tanaes/slide_led_pcb/Slide LED connector v0.2.kicad_sch

## KiCad design Slide LED connector v0.2.kicad_sch (2025-04-06)

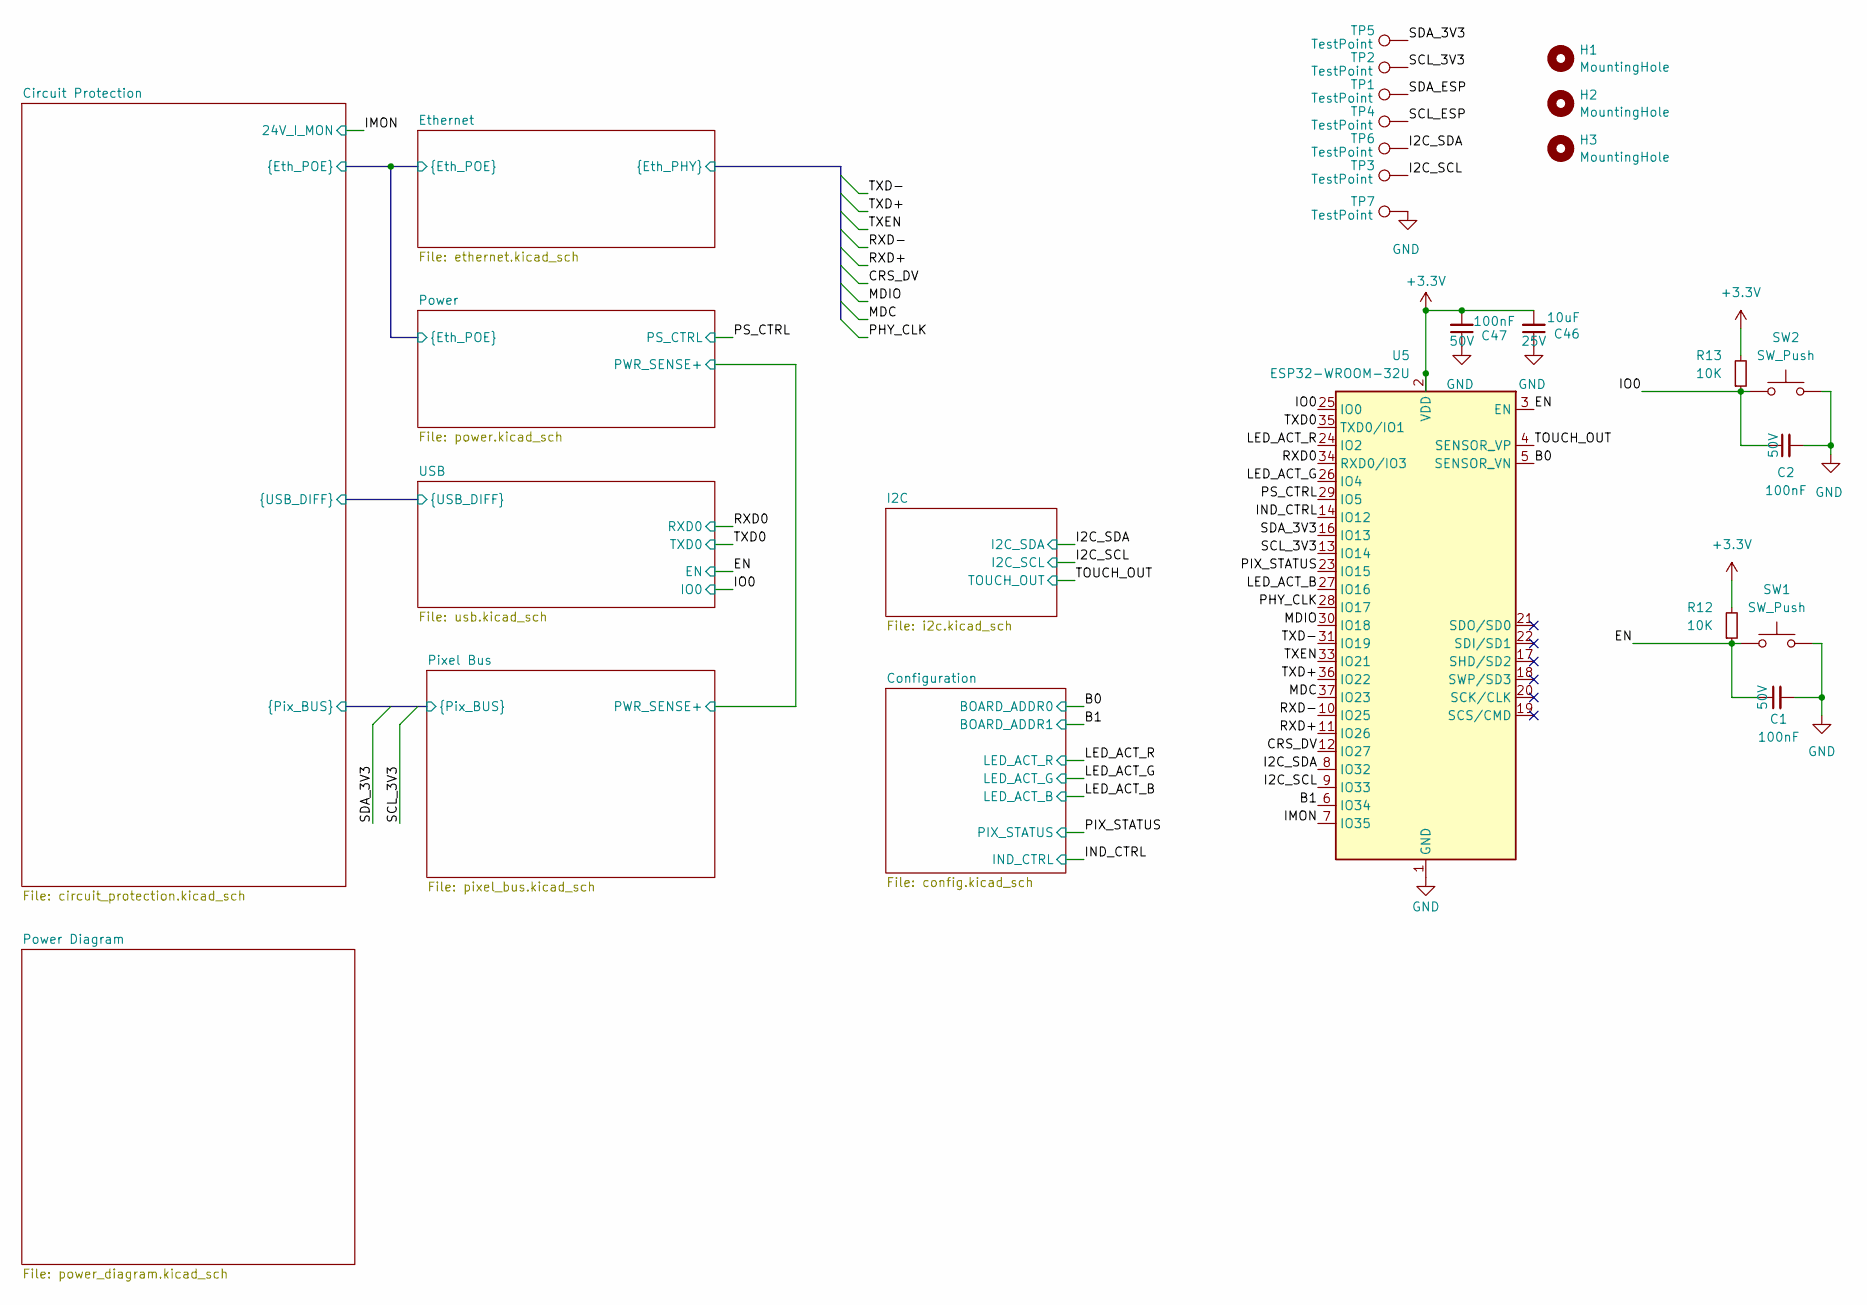
[picture p1: schematic Slide LED connector v0.2.kicad_sch]

Parts:
C1, C2, C47: 100nF; C_0603_1608Metric; Rating 50V; LCSC C14663
C46: 10uF; C_0603_1608Metric; Rating 25V; LCSC C96446
H1, H2, H3: MountingHole; MountingHole_3.2mm_M3_DIN965
R12, R13: 10K; R_0603_1608Metric; LCSC C25804
SW1, SW2: SW_Push; SW_Push_1P1T_XKB_TS-1187A; LCSC C318884
TP1, TP2, TP3, TP4, TP5, TP6, TP7: TestPoint; TestPoint_Pad_D2.0mm
U5: ESP32-WROOM-32U; LCSC C328062

Connections:
+3.3V: C46.2, C47.2, R12.2, R13.2, U5.2 (VDD)
B0: U5.5 (SENSOR_VN)
B1: U5.6 (IO34)
CRS_DV: U5.12 (IO27)
EN: C1.1, R12.1, SW1.1, U5.3 (EN)
GND: C1.2, C2.2, C46.1, C47.1, SW1.2, SW2.2, TP7.1, U5.1 (GND), U5.15 (GND), U5.38 (GND), U5.39 (GND)
I2C_SCL: TP3.1, U5.9 (IO33)
I2C_SDA: TP6.1, U5.8 (IO32)
IMON: U5.7 (IO35)
IND_CTRL: U5.14 (IO12)
IO0: C2.1, R13.1, SW2.1, U5.25 (IO0)
LED_ACT_B: U5.27 (IO16)
LED_ACT_G: U5.26 (IO4)
LED_ACT_R: U5.24 (IO2)
MDC: U5.37 (IO23)
MDIO: U5.30 (IO18)
PHY_CLK: U5.28 (IO17)
PIX_STATUS: U5.23 (IO15)
PS_CTRL: U5.29 (IO5)
RXD0: U5.34 (RXD0/IO3)
RXD+: U5.11 (IO26)
RXD-: U5.10 (IO25)
SCL_3V3: TP2.1, U5.13 (IO14)
SCL_ESP: TP4.1
SDA_3V3: TP5.1, U5.16 (IO13)
SDA_ESP: TP1.1
TOUCH_OUT: U5.4 (SENSOR_VP)
TXD0: U5.35 (TXD0/IO1)
TXD+: U5.36 (IO22)
TXD-: U5.31 (IO19)
TXEN: U5.33 (IO21)
