tanaes/slide_led_pcb/circuit_protection.kicad_sch

## KiCad design circuit_protection.kicad_sch (2025-04-06)

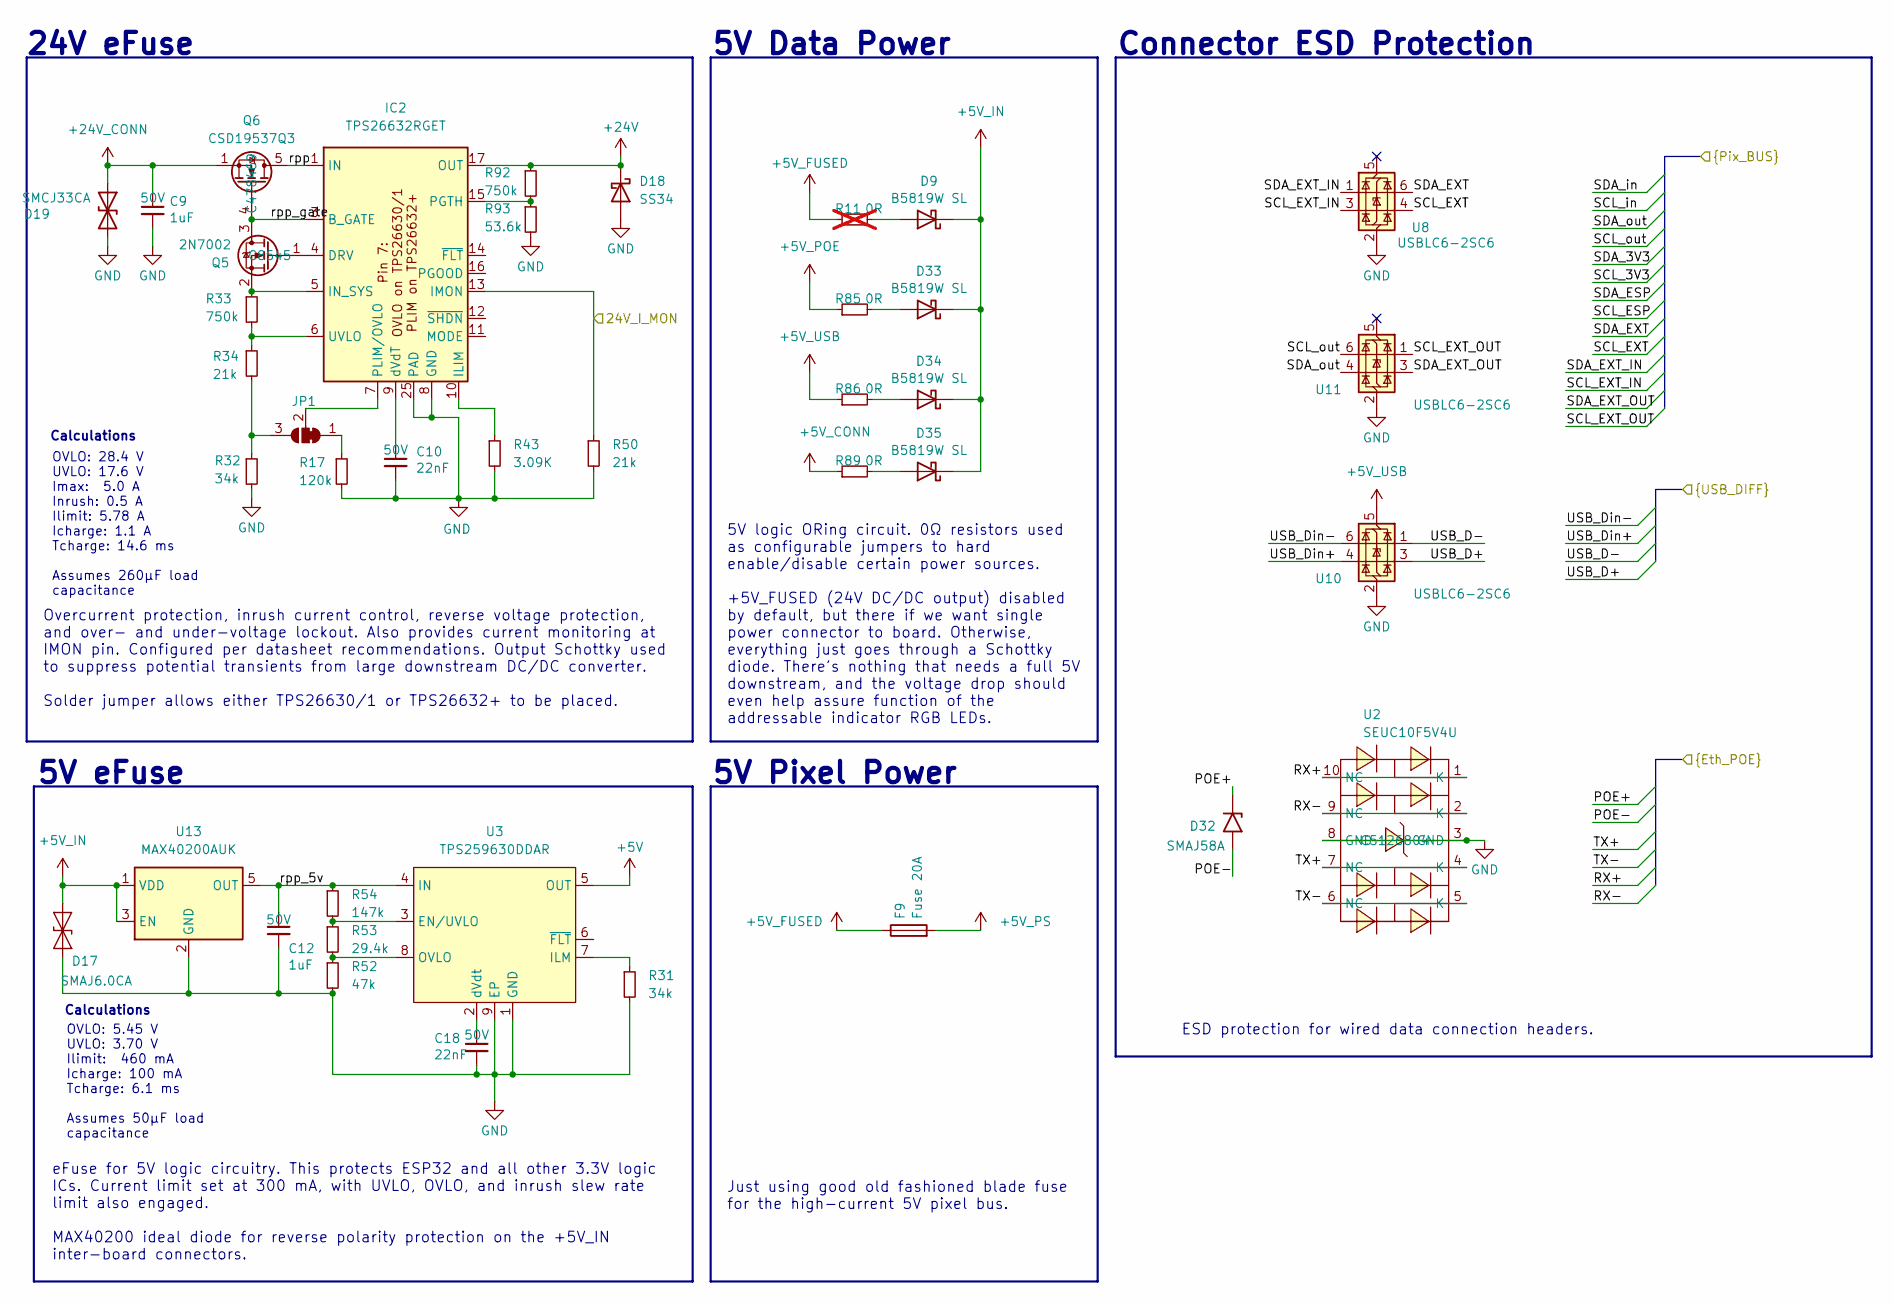
[picture p2: schematic circuit_protection.kicad_sch]

Parts:
C9, C12: 1uF; C_0603_1608Metric; Rating 50V; LCSC C15849
C10, C18: 22nF; C_0603_1608Metric; Rating 50V; LCSC C21122
D9, D33, D34, D35: B5819W SL; D_SOD-123; LCSC C8598
D17: SMAJ6.0CA; D_SMA; LCSC C80275
D18: SS34; D_SMA; LCSC C8678
D19: SMCJ33CA; D_SMC; LCSC C224050
D32: SMAJ58A; D_SMA; LCSC C148235
F9: Fuse 20A; FUSE-TH_4P-L16.0-W6.7; LCSC C19727305
IC2: TPS26632RGET; Texas_RGE0024H_VQFN-24-1EP_4x4mm_P0.5mm_EP2.7x2.7mm_Thermal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; Manufacturer_Part_Number TPS26632RGET; LCSC C2862529
JP1: SolderJumper_3_Bridged12; SolderJumper-3_P1.3mm_Bridged12_RoundedPad1.0x1.5mm
Q5: 2N7002; SOT-23; LCSC C8545
Q6: CSD19537Q3; VSON-8_3.3x3.3mm_P0.65mm_NexFET; LCSC C478469
R11: 0R; R_0603_1608Metric; LCSC C21189; not fitted
R17: 120k; R_0603_1608Metric; LCSC C114607
R31, R32: 34k; R_0603_1608Metric; LCSC C21190
R33, R92: 750k; R_0603_1608Metric; LCSC C21190
R34, R50: 21k; R_0603_1608Metric; LCSC C21190
R43: 3.09K; R_0603_1608Metric; LCSC C21190
R52: 47k; R_0603_1608Metric; LCSC C25819
R53: 29.4k; R_0603_1608Metric; LCSC C22974
R54: 147k; R_0603_1608Metric; LCSC C2998060
R85, R86, R89: 0R; R_0603_1608Metric; LCSC C21189
R93: 53.6k; R_0603_1608Metric; LCSC C2930115
U2: SEUC10F5V4U; DFN2510-10_L2.5-W1.0-P0.50-BL; LCSC Part C5126804
U3: TPS259630DDAR; SOIC-8-1EP_3.9x4.9mm_P1.27mm_EP2.29x3mm; LCSC Part C2155778
U8, U10, U11: USBLC6-2SC6; SOT-23-6; LCSC C2827654
U13: MAX40200AUK; SOT-23-5

Connections:
24V_I_MON: IC2.13 (IMON), R50.1
+5V: U3.5 (OUT)
+5V_CONN: R89.1
+5V_FUSED: F9.1, R11.1
+5V_IN: D9.1 (K), D17.1 (A1), D33.1 (K), D34.1 (K), D35.1 (K), U13.1 (VDD), U13.3 (EN)
+5V_POE: R85.1
+5V_PS: F9.2
+5V_USB: R86.1, U10.5 (VBUS)
+24V: D18.1 (K), IC2.17 (OUT), IC2.18 (OUT), R92.1
+24V_CONN: C9.1, D19.1 (A1), Q6.1 (S), Q6.2 (S), Q6.3 (S)
GND: C9.2, C10.2, C12.2, C18.2, D17.2 (A2), D18.2 (A), D19.2 (A2), IC2.8 (GND), IC2.25 (PAD), R17.2, R31.2, R32.2, R43.2, R50.2, R52.2, R93.2, U2.3 (GND), U2.8 (GND), U3.1 (GND), U3.9 (EP), U8.2 (GND), U10.2 (GND), U11.2 (GND), U13.2 (GND)
unnamed: C10.1, IC2.9 (dVdT)
unnamed: C18.1, U3.2 (dVdt)
unnamed: D9.2 (A), R11.2
unnamed: D33.2 (A), R85.2
unnamed: D34.2 (A), R86.2
unnamed: D35.2 (A), R89.2
unnamed: IC2.4 (DRV), Q5.1 (G)
unnamed: IC2.5 (IN_SYS), Q5.2 (S), R33.1
unnamed: IC2.6 (UVLO), R33.2, R34.1
unnamed: IC2.7 (PLIM/OVLO), JP1.2 (C)
unnamed: IC2.10 (ILIM), R43.1
unnamed: IC2.15 (PGTH), R92.2, R93.1
unnamed: JP1.1 (A), R17.1
unnamed: JP1.3 (B), R32.1, R34.2
unnamed: R31.1, U3.7 (ILM)
unnamed: R52.1, R53.2, U3.8 (OVLO)
unnamed: R53.1, R54.2, U3.3 (EN/UVLO)
POE+: D32.1 (A1)
POE-: D32.2 (A2)
RX+: U2.1 (K), U2.10 (NC)
RX-: U2.2 (K), U2.9 (NC)
SCL_EXT: U8.4 (I/O2)
SCL_EXT_IN: U8.3 (I/O2)
SCL_EXT_OUT: U11.1 (I/O1)
SCL_out: U11.6 (I/O1)
SDA_EXT: U8.6 (I/O1)
SDA_EXT_IN: U8.1 (I/O1)
SDA_EXT_OUT: U11.3 (I/O2)
SDA_out: U11.4 (I/O2)
TX+: U2.4 (K), U2.7 (NC)
TX-: U2.5 (K), U2.6 (NC)
USB_D+: U10.3 (I/O2)
USB_D-: U10.1 (I/O1)
USB_Din+: U10.4 (I/O2)
USB_Din-: U10.6 (I/O1)
rpp: IC2.1 (IN), IC2.2 (IN), Q6.5 (D)
rpp_5v: C12.1, R54.1, U3.4 (IN), U13.5 (OUT)
rpp_gate: IC2.3 (B_GATE), Q5.3 (D), Q6.4 (G)

Notes on the sheet:
Calculations
24V eFuse
Connector ESD Protection
5V eFuse
5V Pixel Power
5V Data Power
Overcurrent protection, inrush current control, reverse voltage protection, and over- and under-voltage lockout. Also provides current monitoring at IMON pin. Configured per datasheet recommendations. Output Schottky used to suppress potential transients from large downstream DC/DC converter. Solde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
eFuse for 5V logic circuitry. This protects ESP32 and all other 3.3V logic ICs. Current limit set at 300 mA, with UVLO, OVLO, and inrush slew rate limit also engaged. MAX40200 ideal diode for reverse polarity protection on the +5V_IN inter-board connectors.
ESD protection for wired data connection headers.
5V logic ORing circuit. 0Ω resistors used as configurable jumpers to hard enable/disable certain power sources. +5V_FUSED (24V DC/DC output) disabled by default, but there if we want single power connector to board. Otherwise, everything just goes through a Schottky diode. There's nothing that need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
Just using good old fashioned blade fuse for the high-current 5V pixel bus.
OVLO: 28.4 V UVLO: 17.6 V Imax: 5.0 A Inrush: 0.5 A Ilimit: 5.78 A Icharge: 1.1 A Tcharge: 14.6 ms Assumes 260µF load capacitance
OVLO: 5.45 V UVLO: 3.70 V Ilimit: 460 mA Icharge: 100 mA Tcharge: 6.1 ms Assumes 50µF load capacitance
