tanaes/slide_led_pcb/config.kicad_sch

## KiCad design config.kicad_sch (2025-04-04)

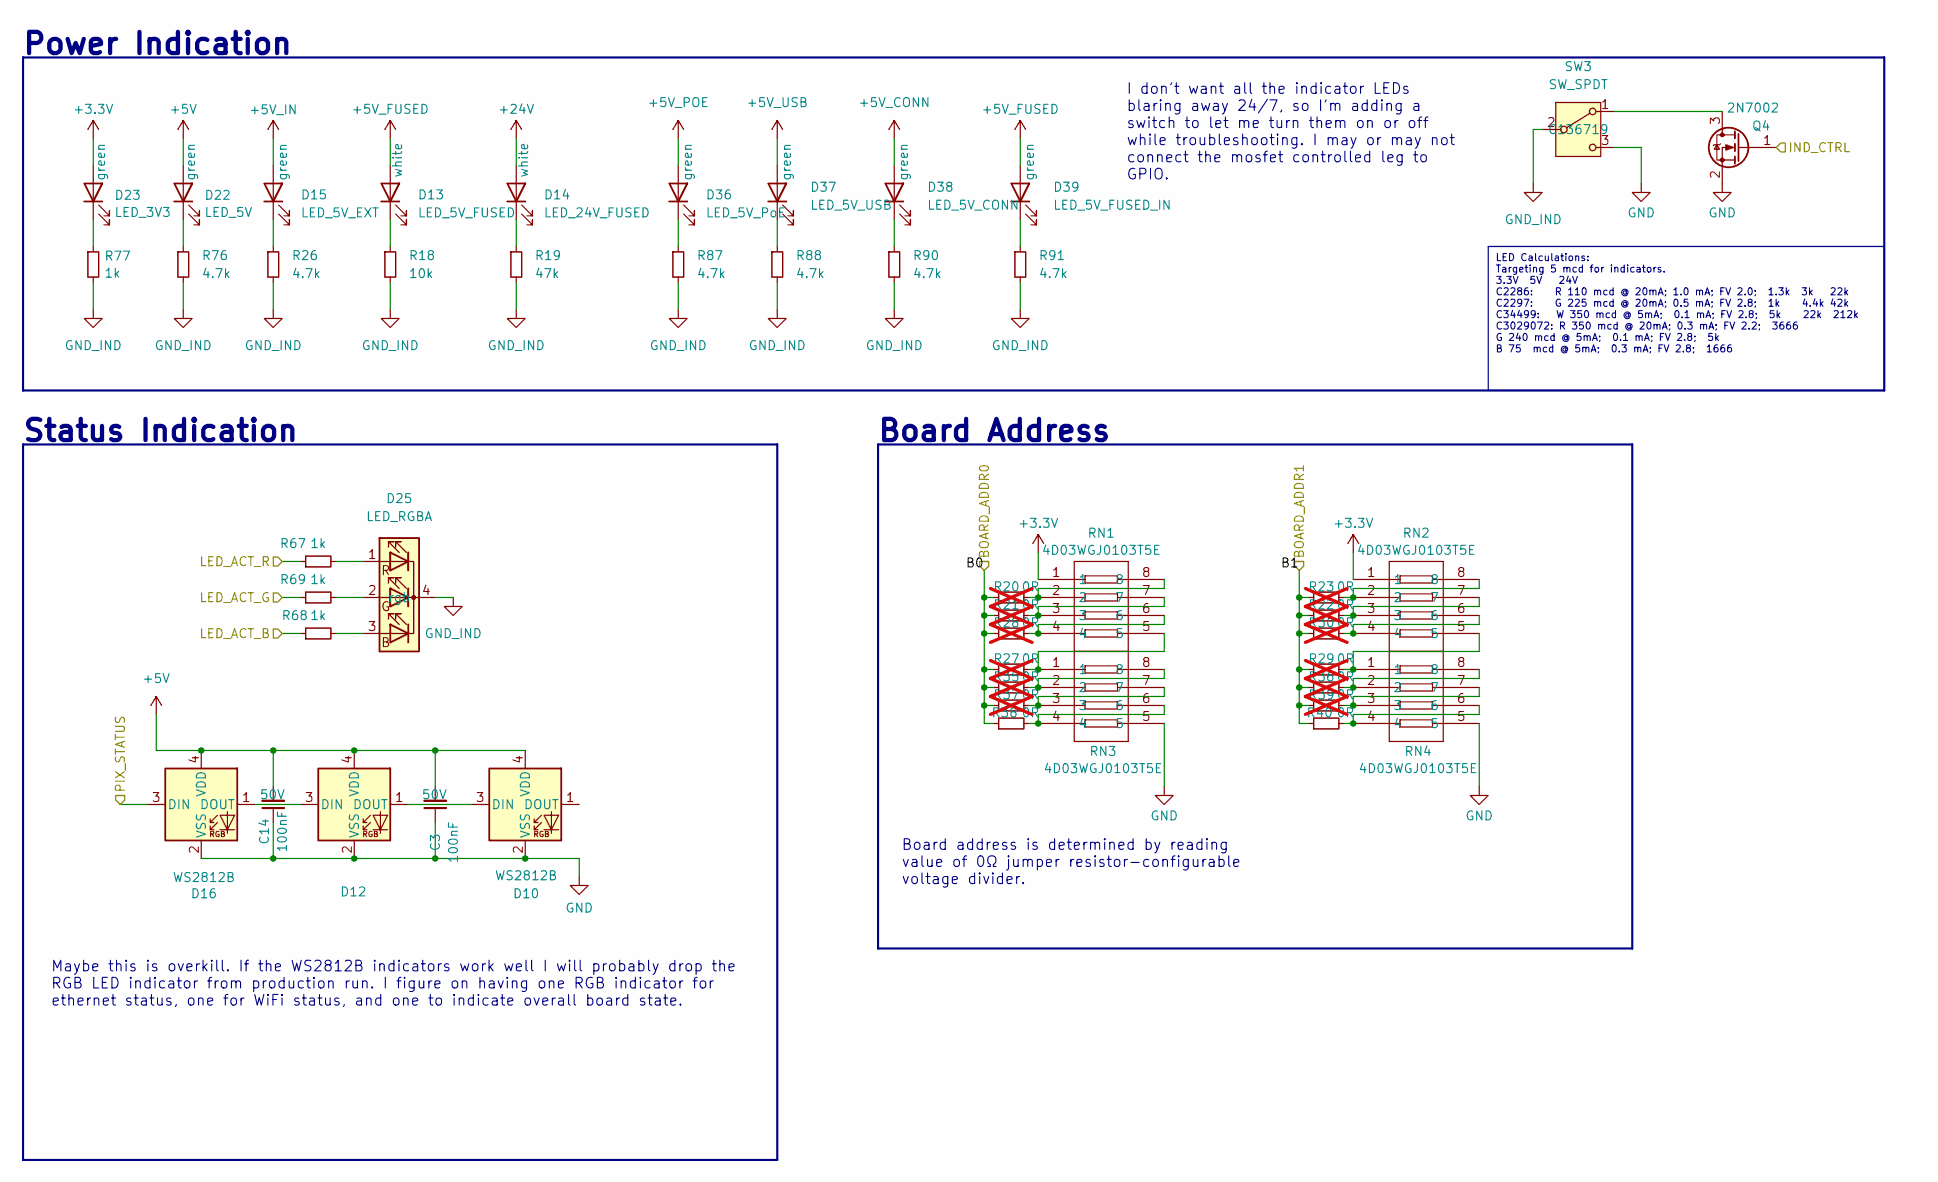
[picture p3: schematic config.kicad_sch]

Parts:
C3, C14: 100nF; C_0603_1608Metric; Rating 50V; LCSC C14663
D10, D12, D16: WS2812B; LED_WS2812B-2020_PLCC4_2.0x2.0mm; LCSC C965555
D13: LED_5V_FUSED; LED_0805_2012Metric; LCSC C34499
D14: LED_24V_FUSED; LED_0805_2012Metric; LCSC C34499
D15: LED_5V_EXT; LED_0805_2012Metric; LCSC C2297
D22: LED_5V; LED_0805_2012Metric; LCSC C2297
D23: LED_3V3; LED_0805_2012Metric; LCSC C2297
D25: LED_RGBA; LED_RGB_1209_CC; LCSC C3029072
D36: LED_5V_PoE; LED_0805_2012Metric; LCSC C2297
D37: LED_5V_USB; LED_0805_2012Metric; LCSC C2297
D38: LED_5V_CONN; LED_0805_2012Metric; LCSC C2297
D39: LED_5V_FUSED_IN; LED_0805_2012Metric; LCSC C2297
Q4: 2N7002; SOT-23; LCSC C8545
R18: 10k; R_0603_1608Metric; LCSC C25804
R19: 47k; R_0603_1608Metric; LCSC C25819
R20, R21, R22, R23, R27, R28, R29, R30, R35, R36, R37, R39: 0R; R_0603_1608Metric; LCSC C21189; not fitted
R26, R76, R87, R88, R90, R91: 4.7k; R_0603_1608Metric; LCSC C23162
R38, R40: 0R; R_0603_1608Metric; LCSC C21189
R67, R68, R69, R77: 1k; R_0603_1608Metric; LCSC C21190
RN1, RN2, RN3, RN4: 4D03WGJ0103T5E; RES-ARRAY-SMD_0603-8P-L3.2-W1.6-BL; LCSC Part C29718
SW3: SW_SPDT; SW-TH_SS-12D02-VG4; LCSC C136719

Connections:
+3.3V: D23.2 (A), RN1.1, RN2.1
+5V: C3.2, C14.2, D10.4 (VDD), D12.4 (VDD), D16.4 (VDD), D22.2 (A)
+5V_CONN: D38.2 (A)
+5V_FUSED: D13.2 (A), D39.2 (A)
+5V_IN: D15.2 (A)
+5V_POE: D36.2 (A)
+5V_USB: D37.2 (A)
+24V: D14.2 (A)
B0: R20.1, R21.1, R27.1, R28.1, R35.1, R37.1, R38.1
B1: R22.1, R23.1, R29.1, R30.1, R36.1, R39.1, R40.1
GND: C3.1, C14.1, D10.2 (VSS), D12.2 (VSS), D16.2 (VSS), Q4.2 (S), RN3.5, RN4.5, SW3.3 (C)
GND_IND: D25.4 (K), R18.2, R19.2, R26.2, R76.2, R77.2, R87.2, R88.2, R90.2, R91.2, SW3.2 (B)
IND_CTRL: Q4.1 (G)
LED_ACT_B: R68.1
LED_ACT_G: R69.1
LED_ACT_R: R67.1
unnamed: D10.3 (DIN), D12.1 (DOUT)
unnamed: D12.3 (DIN), D16.1 (DOUT)
unnamed: D13.1 (K), R18.1
unnamed: D14.1 (K), R19.1
unnamed: D15.1 (K), R26.1
unnamed: D22.1 (K), R76.1
unnamed: D23.1 (K), R77.1
unnamed: D25.1 (RA), R67.2
unnamed: D25.2 (GA), R69.2
unnamed: D25.3 (BA), R68.2
unnamed: D36.1 (K), R87.1
unnamed: D37.1 (K), R88.1
unnamed: D38.1 (K), R90.1
unnamed: D39.1 (K), R91.1
unnamed: Q4.3 (D), SW3.1 (A)
unnamed: R20.2, RN1.2, RN1.8
unnamed: R21.2, RN1.3, RN1.7
unnamed: R22.2, RN2.3, RN2.7
unnamed: R23.2, RN2.2, RN2.8
unnamed: R27.2, RN1.5, RN3.1
unnamed: R28.2, RN1.4, RN1.6
unnamed: R29.2, RN2.5, RN4.1
unnamed: R30.2, RN2.4, RN2.6
unnamed: R35.2, RN3.2, RN3.8
unnamed: R36.2, RN4.2, RN4.8
unnamed: R37.2, RN3.3, RN3.7
unnamed: R38.2, RN3.4, RN3.6
unnamed: R39.2, RN4.3, RN4.7
unnamed: R40.2, RN4.4, RN4.6
PIX_STATUS: D16.3 (DIN)

Notes on the sheet:
Board Address
Status Indication
Power Indication
LED Calculations: Targeting 5 mcd for indicators. 3.3V 5V 24V C2286: R 110 mcd @ 20mA; 1.0 mA; FV 2.0; 1.3k 3k 22k C2297: G 225 mcd @ 20mA; 0.5 mA; FV 2.8; 1k 4.4k 42k C34499: W 350 mcd @ 5mA; 0.1 mA; FV 2.8; 5k 22k 212k C3029072: R 350 mcd @ 20mA; 0.3 mA; FV 2.2; 3666 G 240 mcd @ 5mA; 0.1 mA; FV 2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
I don't want all the indicator LEDs blaring away 24/7, so I'm adding a switch to let me turn them on or off while troubleshooting. I may or may not connect the mosfet controlled leg to GPIO.
Board address is determined by reading value of 0Ω jumper resistor-configurable voltage divider.
Maybe this is overkill. If the WS2812B indicators work well I will probably drop the RGB LED indicator from production run. I figure on having one RGB indicator for ethernet status, one for WiFi status, and one to indicate overall board state.
