tanaes/slide_led_pcb/configuration.kicad_sch

## KiCad design configuration.kicad_sch (2025-04-04)

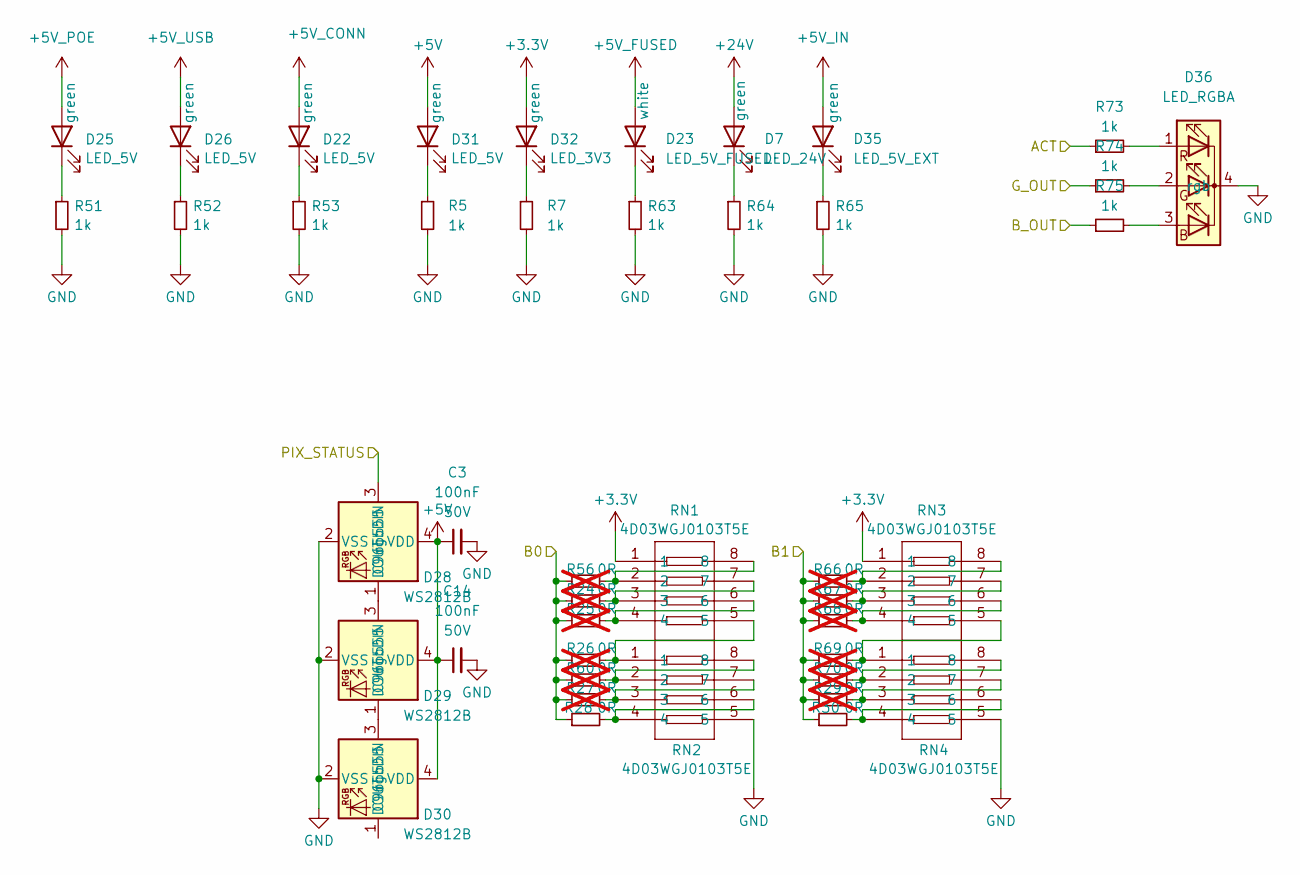
[picture p4: schematic configuration.kicad_sch]

Parts:
C3, C14: 100nF; C_0603_1608Metric; Rating 50V; LCSC C14663
D7: LED_24V; LED_0805_2012Metric; LCSC C2297
D22, D25, D26, D31: LED_5V; LED_0603_1608Metric; LCSC C2297
D23: LED_5V_FUSED; LED_0805_2012Metric; LCSC C34499
D28, D29, D30: WS2812B; LED_WS2812B-2020_PLCC4_2.0x2.0mm; LCSC C965555
D32: LED_3V3; LED_0805_2012Metric; LCSC C2297
D35: LED_5V_EXT; LED_0805_2012Metric; LCSC C2297
D36: LED_RGBA; LED_RGB_1209_CC; LCSC C3029072
R5, R7, R51, R52, R53, R63, R64, R65, R73, R74, R75: 1k; R_0603_1608Metric; LCSC C21190
R24, R25, R26, R27, R29, R56, R60, R66, R67, R68, R69, R70: 0R; R_0603_1608Metric; LCSC C21189; not fitted
R28, R30: 0R; R_0603_1608Metric; LCSC C21189
RN1, RN2, RN3, RN4: 4D03WGJ0103T5E; RES-ARRAY-SMD_0603-8P-L3.2-W1.6-BL; LCSC Part C29718

Connections:
+3.3V: D32.2 (A), RN1.1, RN3.1
+5V: C3.1, C14.1, D28.4 (VDD), D29.4 (VDD), D30.4 (VDD), D31.2 (A)
+5V_CONN: D22.2 (A)
+5V_FUSED: D23.2 (A)
+5V_IN: D35.2 (A)
+5V_POE: D25.2 (A)
+5V_USB: D26.2 (A)
+24V: D7.2 (A)
ACT: R73.1
B0: R24.1, R25.1, R26.1, R27.1, R28.1, R56.1, R60.1
B1: R29.1, R30.1, R66.1, R67.1, R68.1, R69.1, R70.1
B_OUT: R75.1
GND: C3.2, C14.2, D28.2 (VSS), D29.2 (VSS), D30.2 (VSS), D36.4 (K), R5.2, R7.2, R51.2, R52.2, R53.2, R63.2, R64.2, R65.2, RN2.5, RN4.5
G_OUT: R74.1
unnamed: D7.1 (K), R64.1
unnamed: D22.1 (K), R53.1
unnamed: D23.1 (K), R63.1
unnamed: D25.1 (K), R51.1
unnamed: D26.1 (K), R52.1
unnamed: D28.1 (DOUT), D29.3 (DIN)
unnamed: D29.1 (DOUT), D30.3 (DIN)
unnamed: D31.1 (K), R5.1
unnamed: D32.1 (K), R7.1
unnamed: D35.1 (K), R65.1
unnamed: D36.1 (RA), R73.2
unnamed: D36.2 (GA), R74.2
unnamed: D36.3 (BA), R75.2
unnamed: R24.2, RN1.3, RN1.7
unnamed: R25.2, RN1.4, RN1.6
unnamed: R26.2, RN1.5, RN2.1
unnamed: R27.2, RN2.3, RN2.7
unnamed: R28.2, RN2.4, RN2.6
unnamed: R29.2, RN4.3, RN4.7
unnamed: R30.2, RN4.4, RN4.6
unnamed: R56.2, RN1.2, RN1.8
unnamed: R60.2, RN2.2, RN2.8
unnamed: R66.2, RN3.2, RN3.8
unnamed: R67.2, RN3.3, RN3.7
unnamed: R68.2, RN3.4, RN3.6
unnamed: R69.2, RN3.5, RN4.1
unnamed: R70.2, RN4.2, RN4.8
PIX_STATUS: D28.3 (DIN)
