tanaes/slide_led_pcb/ethernet.kicad_sch

## KiCad design ethernet.kicad_sch (2025-04-04)

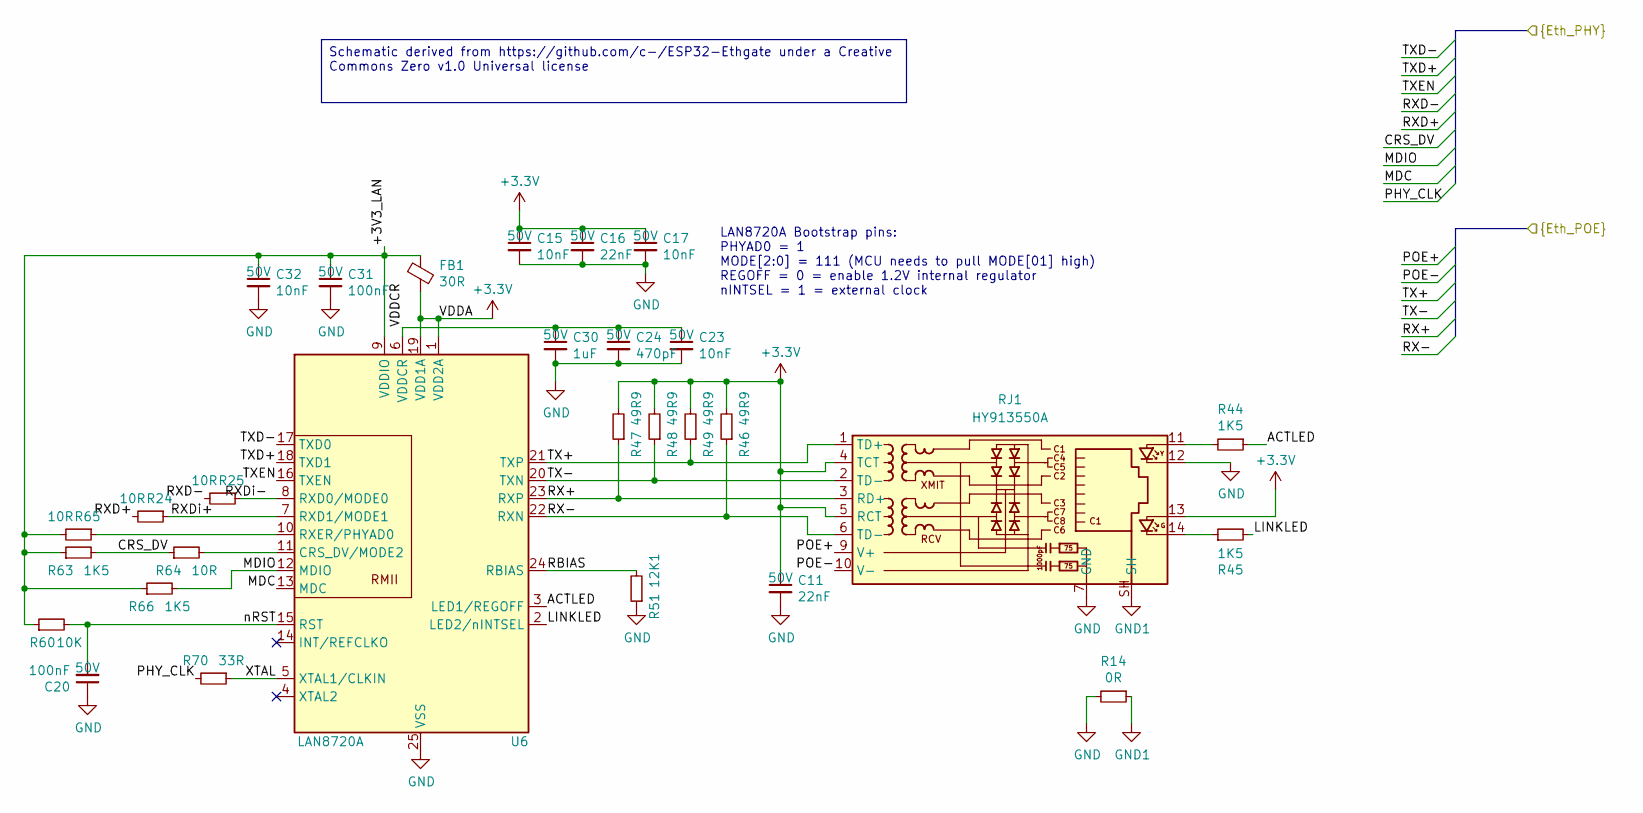
[picture p5: schematic ethernet.kicad_sch]

Parts:
C11, C16: 22nF; C_0603_1608Metric; Rating 50V; LCSC C21122
C15, C17, C23, C32: 10nF; C_0603_1608Metric; Rating 50V; LCSC C57112
C20, C31: 100nF; C_0603_1608Metric; Rating 50V; LCSC C14663
C24: 470pF; C_0603_1608Metric; Rating 50V; LCSC C1620
C30: 1uF; C_0603_1608Metric; Rating 50V; LCSC C15849
FB1: 30R; L_0603_1608Metric; LCSC C17305
R14: 0R; R_0603_1608Metric; LCSC C21189
R24, R25, R64, R65: 10R; R_0603_1608Metric; LCSC C22859
R44, R45, R63, R66: 1K5; R_0603_1608Metric; LCSC C22843
R46, R47, R48, R49: 49R9; R_0402_1005Metric; LCSC C25120
R51: 12K1; R_0603_1608Metric; LCSC C22864
R60: 10K; R_0603_1608Metric; LCSC C25804
R70: 33R; R_0603_1608Metric; LCSC C23140
RJ1: HY913550A; RJ45-TH_ARJP11A-MASA-B-A-EMU2; LCSC Part C19724782
U6: LAN8720A; QFN-24-1EP_4x4mm_P0.5mm_EP2.6x2.6mm; LCSC C45223

Connections:
+3.3V: C11.1, C15.1, C16.1, C17.1, FB1.2, R46.2, R47.2, R48.2, R49.2, RJ1.4 (TCT), RJ1.5 (RCT), RJ1.13, U6.1 (VDD2A), U6.19 (VDD1A)
+3V3_LAN: C31.1, C32.1, FB1.1, R60.1, R63.1, R65.2, R66.1, U6.9 (VDDIO)
ACTLED: R44.1, U6.3 (LED1/REGOFF)
CRS_DV: R63.2, R64.1
GND: C11.2, C15.2, C16.2, C17.2, C20.1, C23.2, C24.2, C30.2, C31.2, C32.2, R14.2, R51.1, RJ1.7 (GND), RJ1.12, U6.25 (VSS)
GND1: R14.1, RJ1.SH
LINKLED: R45.2, U6.2 (LED2/nINTSEL)
MDC: U6.13 (MDC)
MDIO: R66.2, U6.12 (MDIO)
unnamed: R44.2, RJ1.11
unnamed: R45.1, RJ1.14
unnamed: R64.2, U6.11 (CRS_DV/MODE2)
unnamed: R65.1, U6.10 (RXER/PHYAD0)
PHY_CLK: R70.2
POE+: RJ1.9 (V+)
POE-: RJ1.10 (V-)
RBIAS: R51.2, U6.24 (RBIAS)
RX+: R47.1, RJ1.3 (RD+), U6.23 (RXP)
RX-: R46.1, RJ1.6 (TD-), U6.22 (RXN)
RXD+: R24.2
RXD-: R25.2
RXDi+: R24.1, U6.7 (RXD1/MODE1)
RXDi-: R25.1, U6.8 (RXD0/MODE0)
TX+: R49.1, RJ1.1 (TD+), U6.21 (TXP)
TX-: R48.1, RJ1.2 (TD-), U6.20 (TXN)
TXD+: U6.18 (TXD1)
TXD-: U6.17 (TXD0)
TXEN: U6.16 (TXEN)
VDDCR: C23.1, C24.1, C30.1, U6.6 (VDDCR)
XTAL: R70.1, U6.5 (XTAL1/CLKIN)
nRST: C20.2, R60.2, U6.15 (RST)

Notes on the sheet:
LAN8720A Bootstrap pins: PHYAD0 = 1 MODE[2:0] = 111 (MCU needs to pull MODE[01] high) REGOFF = 0 = enable 1.2V internal regulator nINTSEL = 1 = external clock
Schematic derived from https://github.com/c-/ESP32-Ethgate under a Creative Commons Zero v1.0 Universal license
