tanaes/slide_led_pcb/i2c.kicad_sch

## KiCad design i2c.kicad_sch (2025-04-04)

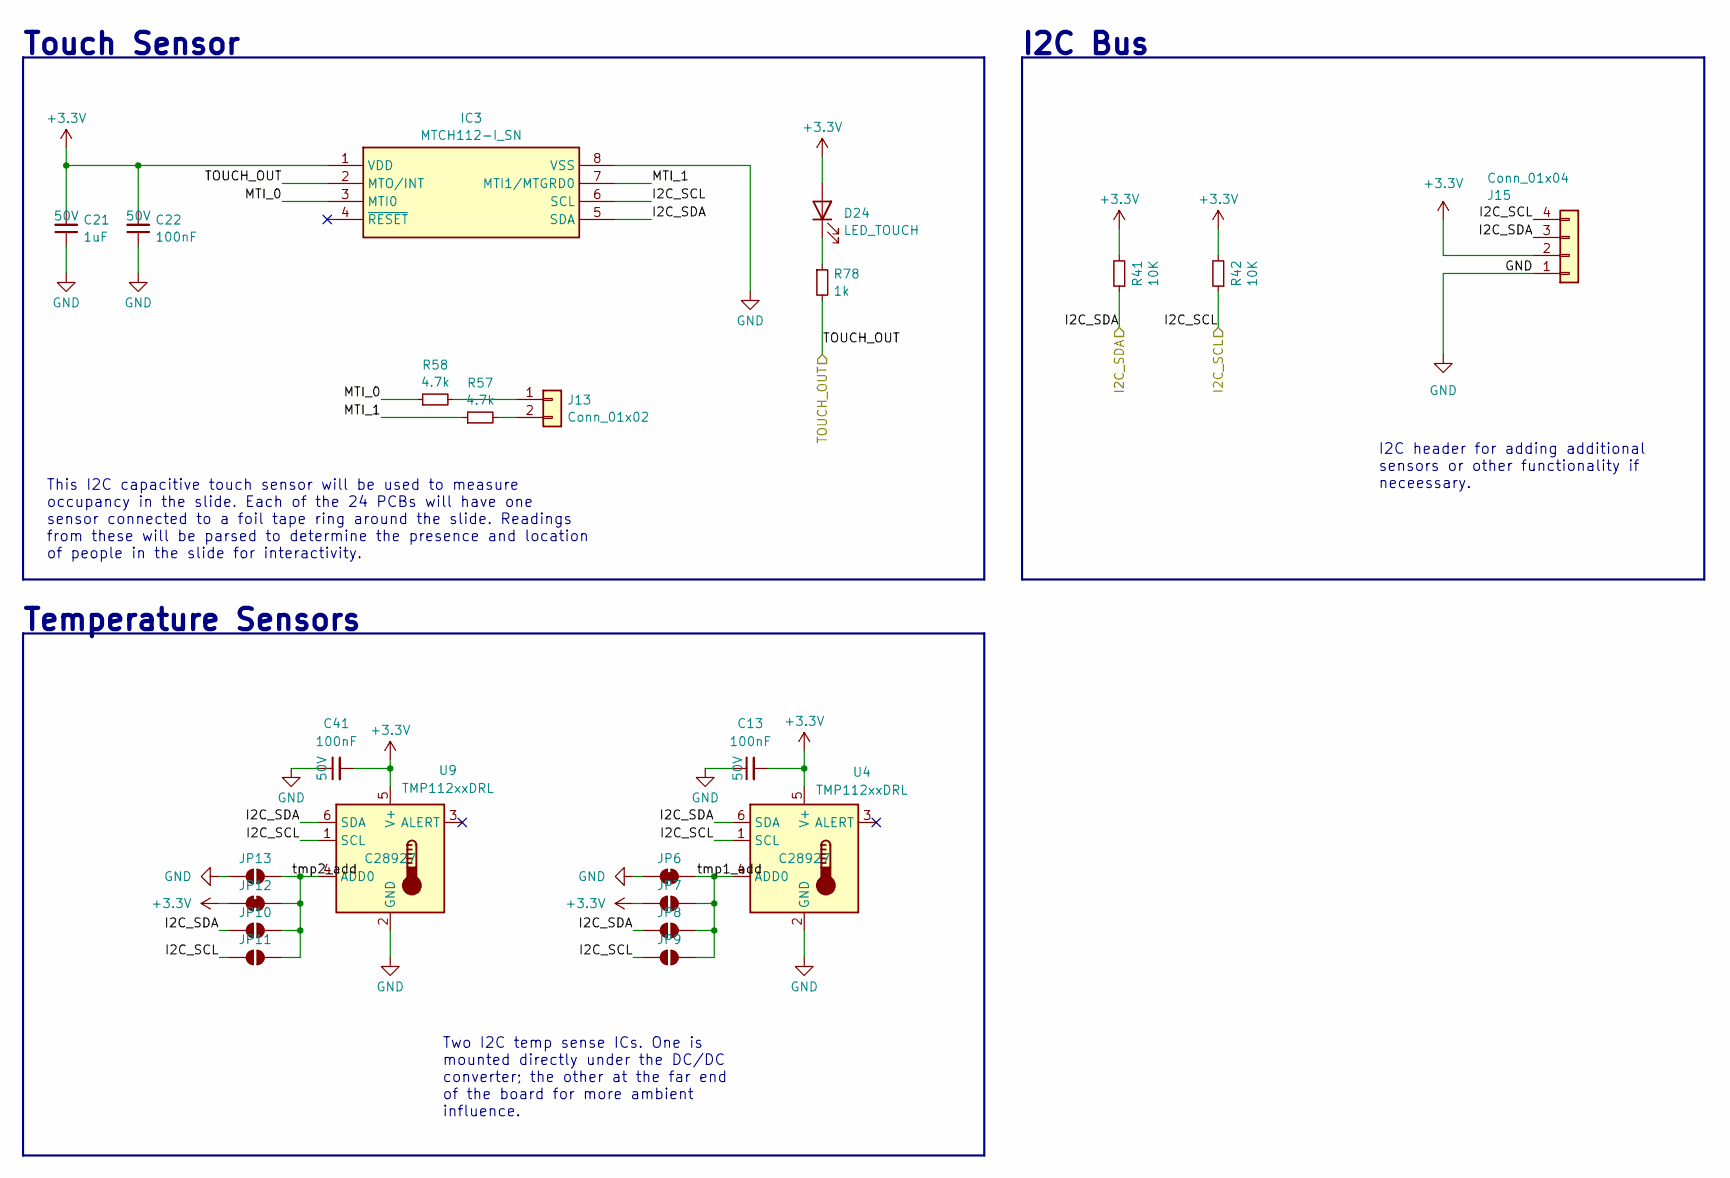
[picture p6: schematic i2c.kicad_sch]

Parts:
C13, C22, C41: 100nF; C_0603_1608Metric; Rating 50V; LCSC C14663
C21: 1uF; C_0603_1608Metric; Rating 50V; LCSC C15849
D24: LED_TOUCH; LED_0805_2012Metric; LCSC C84256
IC3: MTCH112-I_SN; SOIC-8_3.9x4.9mm_P1.27mm; Mouser Part Number 579-MTCH112-I/SN
J13: Conn_01x02; JST_PH_B2B-PH-K_1x02_P2.00mm_Vertical; LCSC C131337
J15: Conn_01x04; JST_PH_B4B-PH-K_1x04_P2.00mm_Vertical; LCSC C131334
JP6, JP12: SolderJumper_2_Bridged; SolderJumper-2_P1.3mm_Bridged_RoundedPad1.0x1.5mm
JP7, JP8, JP9, JP10, JP11, JP13: SolderJumper_2_Open; SolderJumper-2_P1.3mm_Open_RoundedPad1.0x1.5mm
R41, R42: 10K; R_0603_1608Metric; LCSC C25804
R57, R58: 4.7k; R_0603_1608Metric; LCSC C23162
R78: 1k; R_0603_1608Metric; LCSC C21190
U4, U9: TMP112xxDRL; SOT-563; LCSC C28927

Connections:
+3.3V: C13.2, C21.2, C22.2, C41.2, D24.2 (A), IC3.1 (VDD), J15.2, JP7.1 (A), JP12.1 (A), R41.2, R42.2, U4.5 (V+), U9.5 (V+)
GND: C13.1, C21.1, C22.1, C41.1, IC3.8 (VSS), J15.1, JP6.1 (A), JP13.1 (A), U4.2 (GND), U9.2 (GND)
I2C_SCL: IC3.6 (SCL), J15.4, JP9.1 (A), JP11.1 (A), R42.1, U4.1 (SCL), U9.1 (SCL)
I2C_SDA: IC3.5 (SDA), J15.3, JP8.1 (A), JP10.1 (A), R41.1, U4.6 (SDA), U9.6 (SDA)
MTI_0: IC3.3 (MTI0), R58.1
MTI_1: IC3.7 (MTI1/MTGRD0), R57.1
unnamed: D24.1 (K), R78.1
unnamed: J13.1, R58.2
unnamed: J13.2, R57.2
TOUCH_OUT: IC3.2 (MTO/INT), R78.2
tmp1_add: JP6.2 (B), JP7.2 (B), JP8.2 (B), JP9.2 (B), U4.4 (ADD0)
tmp2_add: JP10.2 (B), JP11.2 (B), JP12.2 (B), JP13.2 (B), U9.4 (ADD0)

Notes on the sheet:
I2C Bus
Touch Sensor
Temperature Sensors
This I2C capacitive touch sensor will be used to measure occupancy in the slide. Each of the 24 PCBs will have one sensor connected to a foil tape ring around the slide. Readings from these will be parsed to determine the presence and location of people in the slide for interactivity.
I2C header for adding additional sensors or other functionality if neceessary.
Two I2C temp sense ICs. One is mounted directly under the DC/DC converter; the other at the far end of the board for more ambient influence.
