tanaes/slide_led_pcb/led.kicad_sch

## KiCad design led.kicad_sch (2025-04-04)

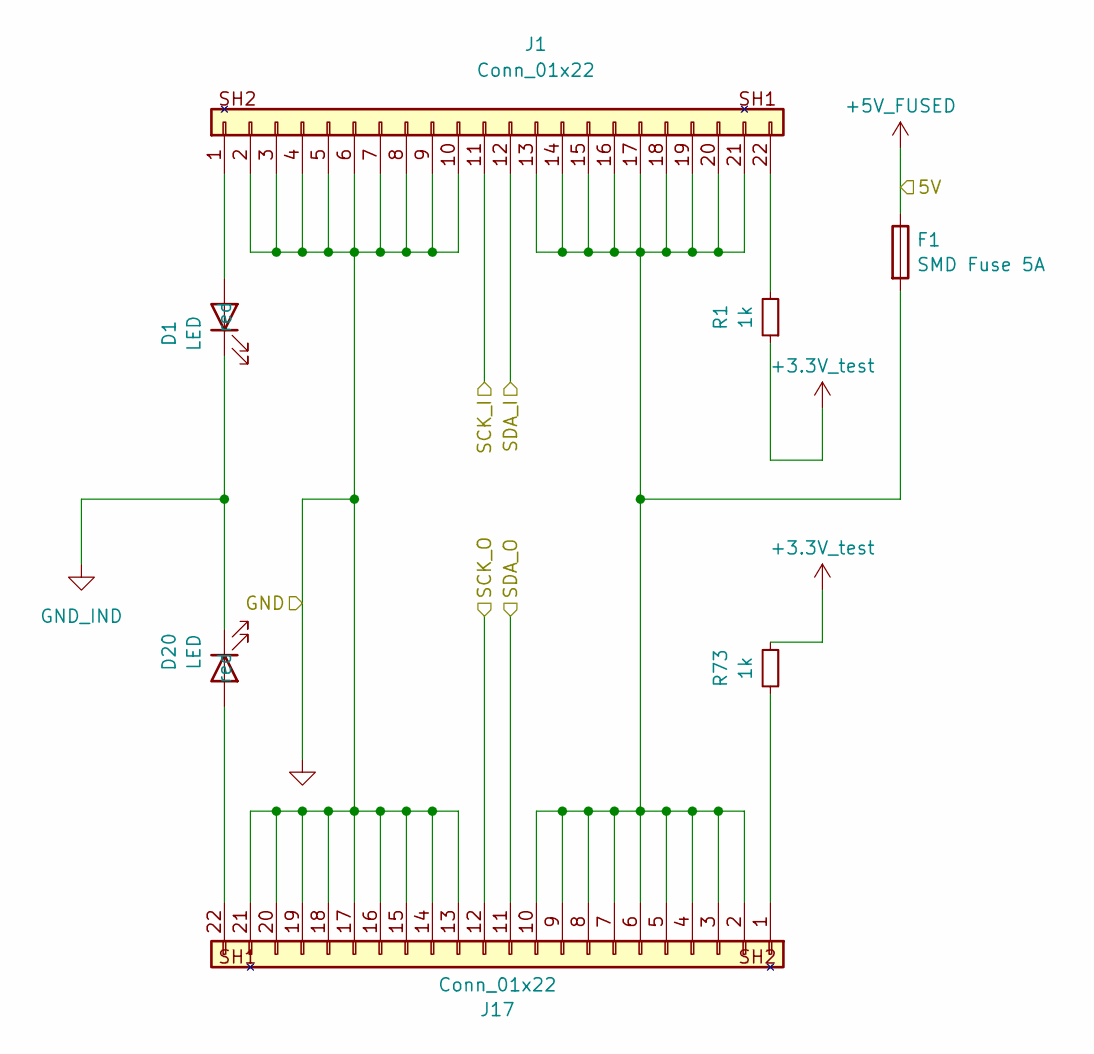
[picture p7: schematic led.kicad_sch]

Parts:
D1, D20: LED; LED_0603_1608Metric; LCSC C2286
F1: SMD Fuse 5A; Fuse_1206_3216Metric; LCSC C57525
J1, J17: Conn_01x22; AMPHENOL_F305-1A7H1-21022-E100; LCSC C3168287
R1, R73: 1k; R_0603_1608Metric; LCSC C21190

Connections:
+3.3V_test: R1.1, R73.1
+5V_FUSED: F1.1
GND: J1.2, J1.3, J1.4, J1.5, J1.6, J1.7, J1.8, J1.9, J1.10, J17.13, J17.14, J17.15, J17.16, J17.17, J17.18, J17.19, J17.20, J17.21
GND_IND: D1.1 (K), D20.1 (K)
unnamed: D1.2 (A), J1.1
unnamed: D20.2 (A), J17.22
unnamed: F1.2, J1.13, J1.14, J1.15, J1.16, J1.17, J1.18, J1.19, J1.20, J1.21, J17.2, J17.3, J17.4, J17.5, J17.6, J17.7, J17.8, J17.9, J17.10
unnamed: J1.22, R1.2
unnamed: J17.1, R73.2
SCK_I: J1.11
SCK_O: J17.12
SDA_I: J1.12
SDA_O: J17.11
