tanaes/slide_led_pcb/pixel_bus.kicad_sch

## KiCad design pixel_bus.kicad_sch (2025-04-04)

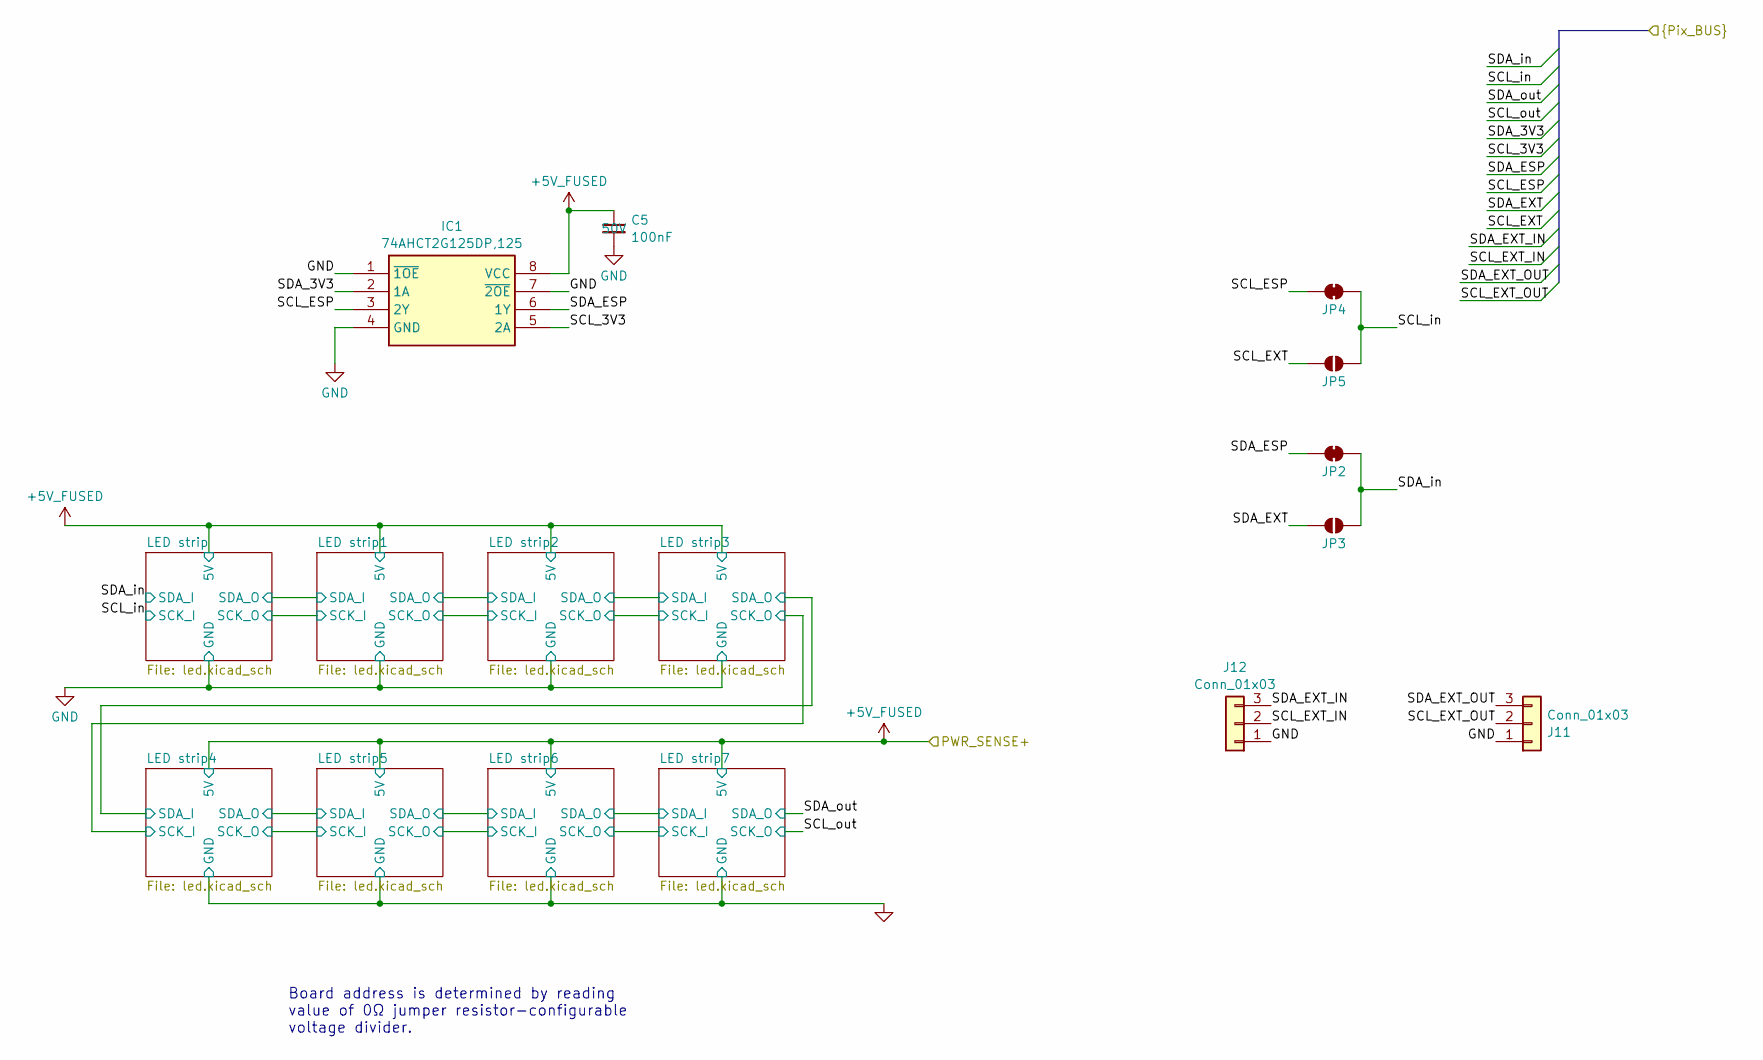
[picture p8: schematic pixel_bus.kicad_sch]

Parts:
C5: 100nF; C_0603_1608Metric; Rating 50V; LCSC C14663
IC1: 74AHCT2G125DP,125; TSSOP-8_3x3mm_P0.65mm; Mouser Part Number 771-AHCT2G125DP125
J11, J12: Conn_01x03; JST_PH_B3B-PH-K_1x03_P2.00mm_Vertical; LCSC C131339
JP2, JP4: SolderJumper_2_Bridged; SolderJumper-2_P1.3mm_Bridged_RoundedPad1.0x1.5mm
JP3, JP5: SolderJumper_2_Open; SolderJumper-2_P1.3mm_Open_RoundedPad1.0x1.5mm

Connections:
+5V_FUSED: C5.1, IC1.8 (VCC)
GND: C5.2, IC1.1 (~1OE), IC1.4 (GND), IC1.7 (~2OE), J11.1, J12.1
SCL_3V3: IC1.5 (2A)
SCL_ESP: IC1.3 (2Y), JP4.2 (B)
SCL_EXT: JP5.2 (B)
SCL_EXT_IN: J12.2
SCL_EXT_OUT: J11.2
SCL_in: JP4.1 (A), JP5.1 (A)
SDA_3V3: IC1.2 (1A)
SDA_ESP: IC1.6 (1Y), JP2.2 (B)
SDA_EXT: JP3.2 (B)
SDA_EXT_IN: J12.3
SDA_EXT_OUT: J11.3
SDA_in: JP2.1 (A), JP3.1 (A)

Notes on the sheet:
Board address is determined by reading value of 0Ω jumper resistor-configurable voltage divider.
