tanaes/slide_led_pcb/power.kicad_sch

## KiCad design power.kicad_sch (2025-04-05)

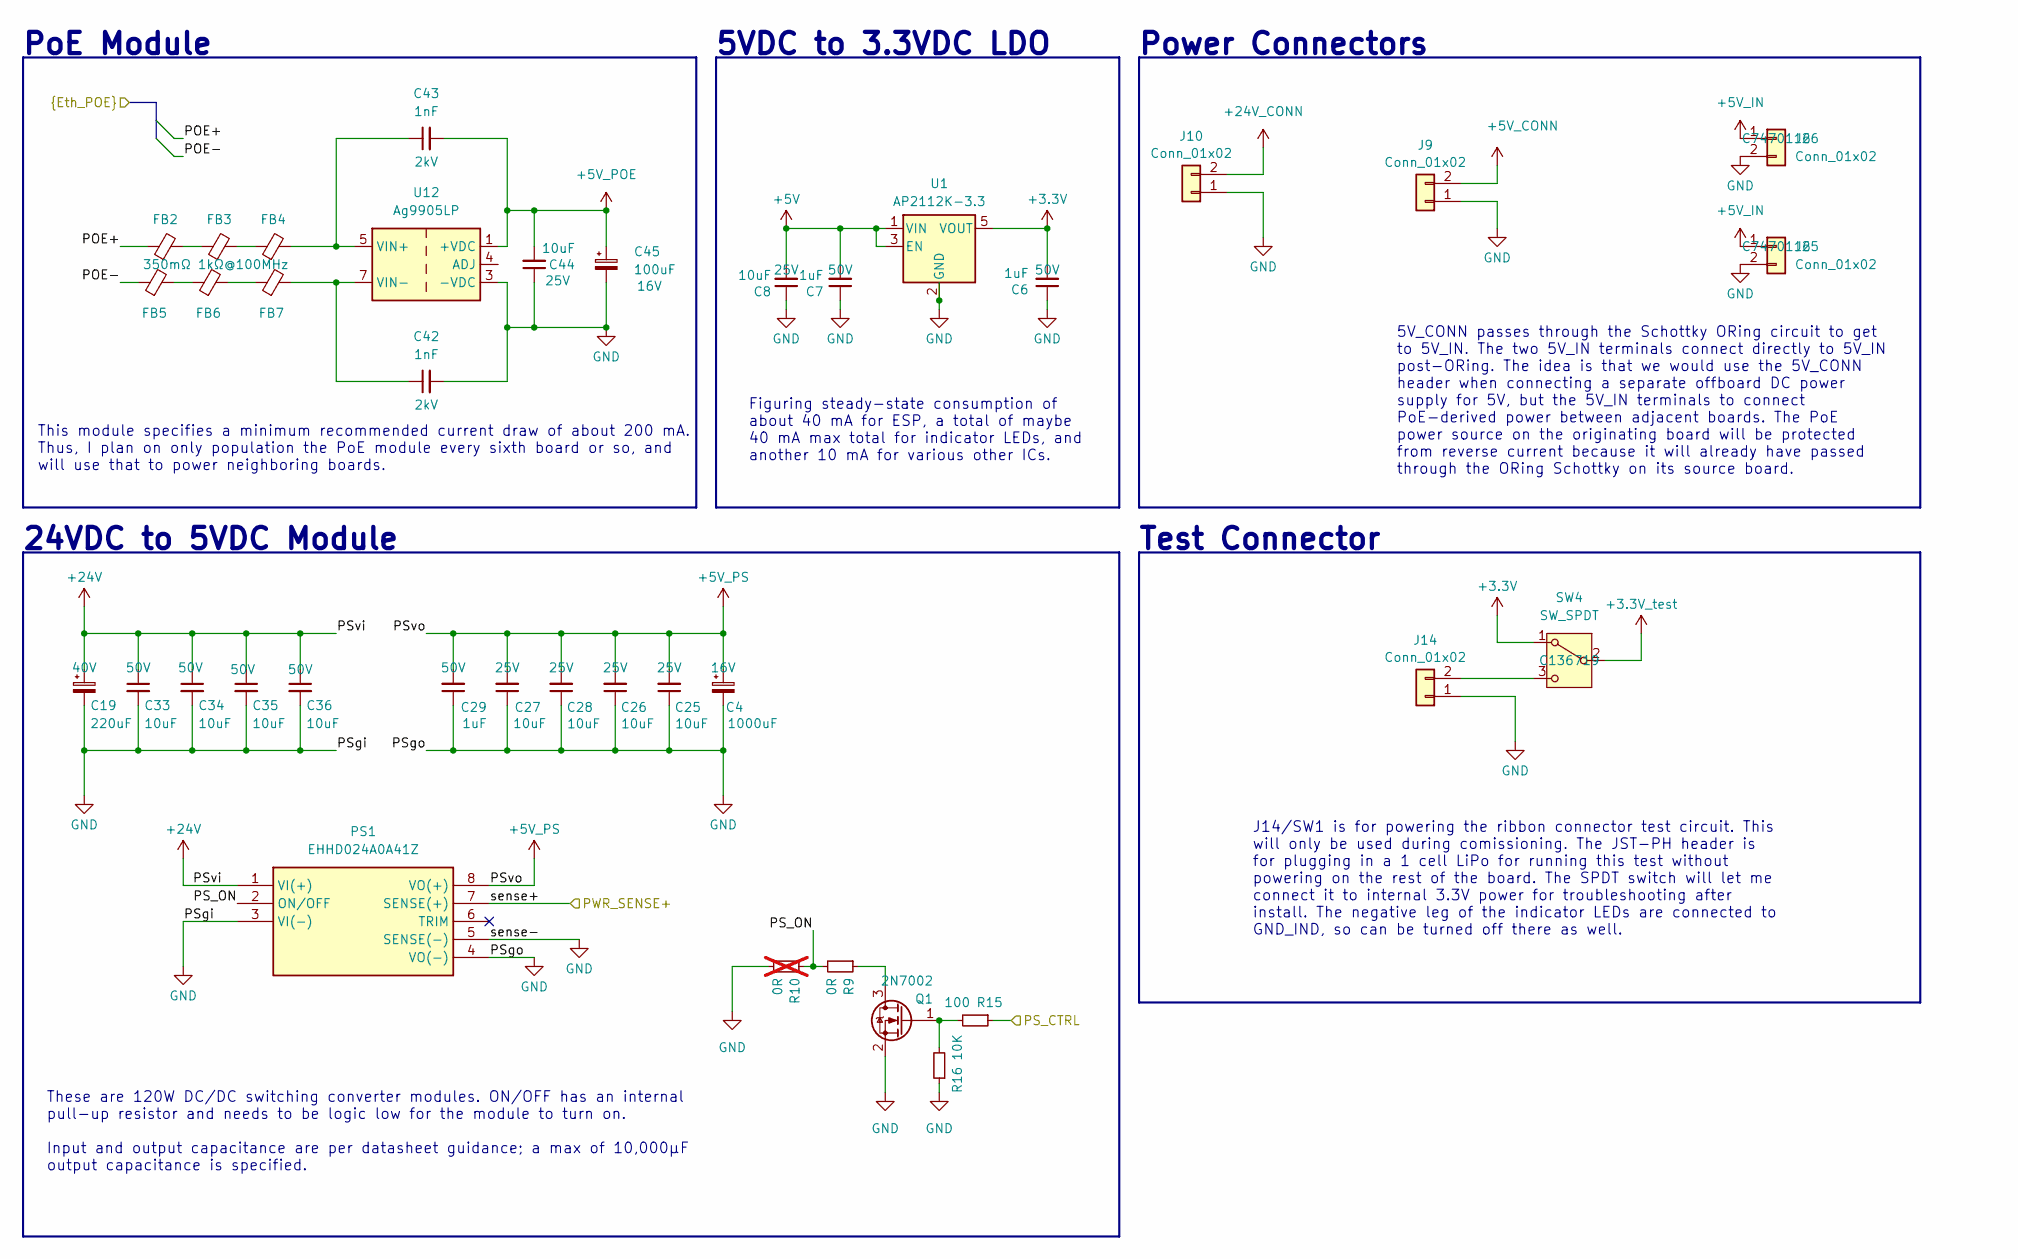
[picture p9: schematic power.kicad_sch]

Parts:
C4: 1000uF; CP_Elec_10x10.5; Rating 16V; LCSC C3274494
C6, C7, C29: 1uF; C_0603_1608Metric; Rating 50V; LCSC C15849
C8, C25, C26, C27, C28, C44: 10uF; C_0603_1608Metric; Rating 25V; LCSC C96446
C19: 220uF; CP_Elec_10x10.5; Rating 40V; LCSC C1882684
C33, C34, C35, C36: 10uF; C_1206_3216Metric; Rating 50V; LCSC C13585
C42, C43: 1nF; C_1206_3216Metric; Rating 2kV; LCSC C23631
C45: 100uF; CP_Elec_6.3x5.8; Rating 16V; LCSC C2162384
FB2, FB3, FB4, FB5, FB6, FB7: 350mΩ 1kΩ@100MHz; L_0805_2012Metric; Manufacturer_Part_Number MMZ2012S102ATD25; LCSC C502000
J9, J25, J26: Conn_01x02; CONN-TH_2P-MX250-3.5-02P-B-GY01-CU-A; LCSC C7470116
J10: Conn_01x02; CONN-TH_4P-P5.00_1862411; LCSC C475222
J14: Conn_01x02; JST_PH_B2B-PH-K_1x02_P2.00mm_Vertical; LCSC C131337
PS1: EHHD024A0A41Z; Manufacturer_Part_Number EHHD024A0A41Z
Q1: 2N7002; SOT-23; LCSC C8545
R9: 0R; R_0603_1608Metric; LCSC C21189
R10: 0R; R_0603_1608Metric; LCSC C21189; not fitted
R15: 100; R_0603_1608Metric; LCSC C22775
R16: 10K; R_0603_1608Metric; LCSC C25804
SW4: SW_SPDT; SW-TH_SS-12D02-VG4; LCSC C136719
U1: AP2112K-3.3; SOT-25-5; LCSC C51118
U12: Ag9905LP; Converter_DCDC_Silvertel_Ag99xxLP_THT

Connections:
+3.3V: C6.2, SW4.1 (A), U1.5 (VOUT)
+3.3V_test: SW4.2 (B)
+5V: C7.2, C8.2, U1.1 (VIN), U1.3 (EN)
+5V_CONN: J9.2
+5V_IN: J25.1, J26.1
+5V_POE: C43.2, C44.2, C45.1, U12.1 (+VDC), U12.2 (+VDC)
+5V_PS: C4.1, C25.2, C26.2, C27.2, C28.2, C29.2, PS1.8 (VO(+))
+24V: C19.1, C33.1, C34.1, C35.1, C36.1, PS1.1 (VI(+))
+24V_CONN: J10.2
GND: C4.2, C6.1, C7.1, C8.1, C19.2, C25.1, C26.1, C27.1, C28.1, C29.1, C33.2, C34.2, C35.2, C36.2, C42.2, C44.1, C45.2, J9.1, J10.1, J14.1, J25.2, J26.2, PS1.3 (VI(-)), PS1.4 (VO(-)), PS1.5 (SENSE(-)), Q1.2 (S), R10.2, R16.1, U1.2 (GND), U12.3 (-VDC)
unnamed: C42.1, FB7.2, U12.7 (VIN-), U12.8 (VIN-)
unnamed: C43.1, FB4.2, U12.5 (VIN+), U12.6 (VIN+)
unnamed: FB2.2, FB3.1
unnamed: FB3.2, FB4.1
unnamed: FB5.2, FB6.1
unnamed: FB6.2, FB7.1
unnamed: J14.2, SW4.3 (C)
unnamed: Q1.1 (G), R15.2, R16.2
unnamed: Q1.3 (D), R9.1
POE+: FB2.1
POE-: FB5.1
PS_CTRL: R15.1
PS_ON: PS1.2 (ON/OFF), R9.2, R10.1
PWR_SENSE+: PS1.7 (SENSE(+))

Notes on the sheet:
24VDC to 5VDC Module
Test Connector
5VDC to 3.3VDC LDO
Power Connectors
PoE Module
5V_CONN passes through the Schottky ORing circuit to get to 5V_IN. The two 5V_IN terminals connect directly to 5V_IN post-ORing. The idea is that we would use the 5V_CONN header when connecting a separate offboard DC power supply for 5V, but the 5V_IN terminals to connect PoE-derived power between 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
This module specifies a minimum recommended current draw of about 200 mA. Thus, I plan on only population the PoE module every sixth board or so, and will use that to power neighboring boards.
Figuring steady-state consumption of about 40 mA for ESP, a total of maybe 40 mA max total for indicator LEDs, and another 10 mA for various other ICs.
These are 120W DC/DC switching converter modules. ON/OFF has an internal pull-up resistor and needs to be logic low for the module to turn on. Input and output capacitance are per datasheet guidance; a max of 10,000µF output capacitance is specified.
J14/SW1 is for powering the ribbon connector test circuit. This will only be used during comissioning. The JST-PH header is for plugging in a 1 cell LiPo for running this test without powering on the rest of the board. The SPDT switch will let me connect it to internal 3.3V power for troubleshootin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
