tanaes/slide_led_pcb/usb.kicad_sch

## KiCad design usb.kicad_sch (2025-04-04)

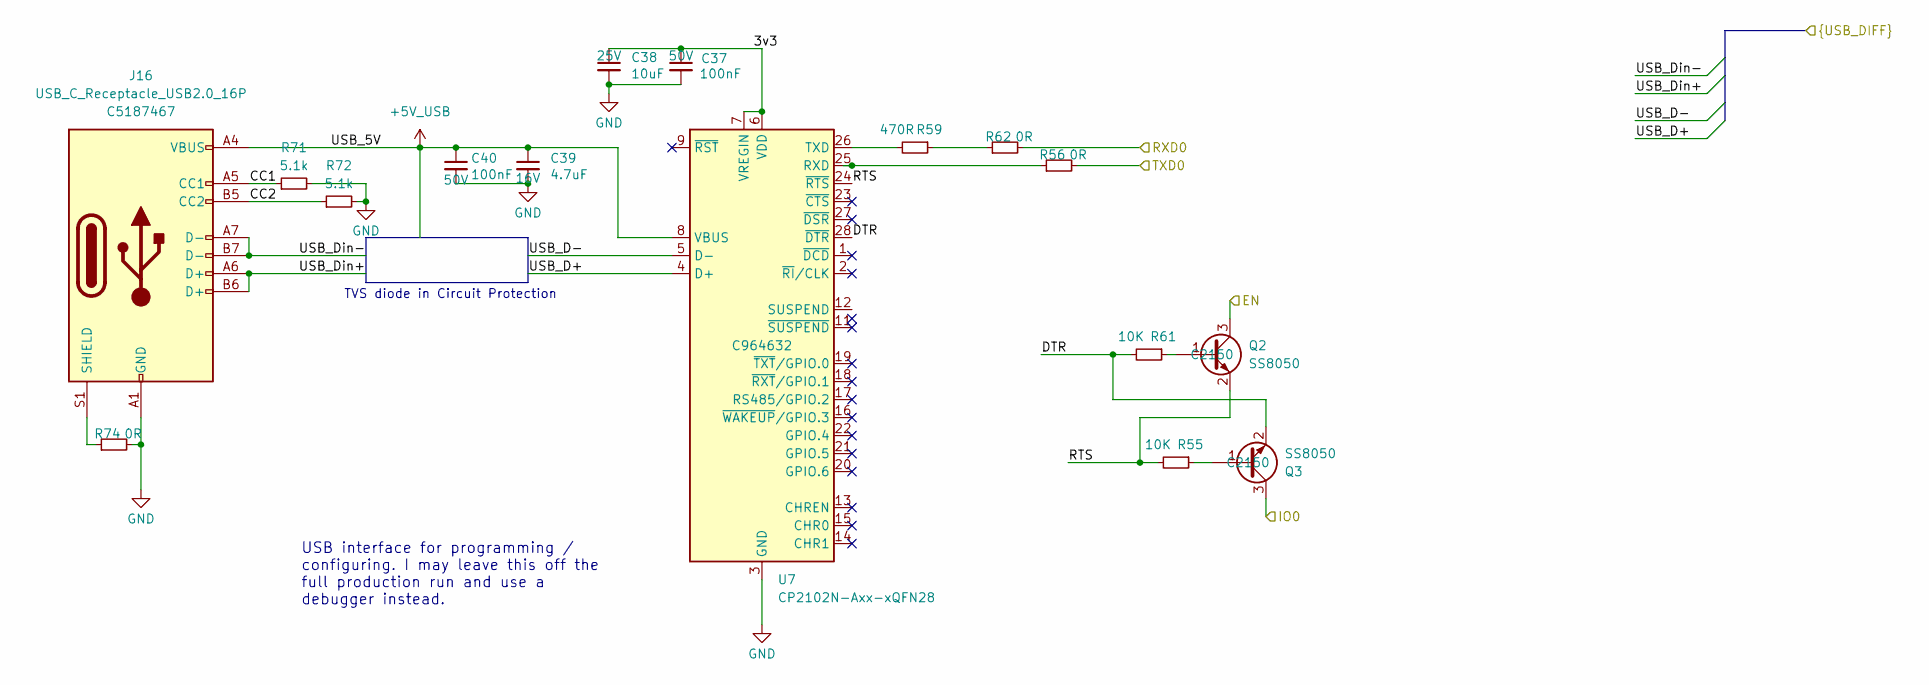
[picture p10: schematic usb.kicad_sch]

Parts:
C37, C40: 100nF; C_0603_1608Metric; Rating 50V; LCSC C14663
C38: 10uF; C_0603_1608Metric; Rating 25V; LCSC C96446
C39: 4.7uF; C_0603_1608Metric; Rating 16V; LCSC C19666
J16: USB_C_Receptacle_USB2.0_16P; TYPE-C-SMD_918-468K2029Y50001; LCSC C5187467
Q2, Q3: SS8050; SOT-23; LCSC C2150
R55, R61: 10K; R_0603_1608Metric; LCSC C25804
R56, R62, R74: 0R; R_0603_1608Metric; LCSC C21189
R59: 470R; R_0603_1608Metric; LCSC C23179
R71, R72: 5.1k; R_0603_1608Metric; LCSC C23186
U7: CP2102N-Axx-xQFN28; QFN-28-1EP_5x5mm_P0.5mm_EP3.35x3.35mm; LCSC C964632

Connections:
3v3: C37.1, C38.1, U7.6 (VDD), U7.7 (VREGIN)
+5V_USB: C39.1, C40.1, J16.A4 (VBUS), J16.A9 (VBUS), J16.B4 (VBUS), J16.B9 (VBUS), U7.8 (VBUS)
CC1: J16.A5 (CC1), R71.1
CC2: J16.B5 (CC2), R72.1
DTR: Q3.2 (E), R61.2, U7.28 (~DTR)
EN: Q2.3 (C)
GND: C37.2, C38.2, C39.2, C40.2, J16.A1 (GND), J16.A12 (GND), J16.B1 (GND), J16.B12 (GND), R71.2, R72.2, R74.2, U7.3 (GND), U7.29 (GND)
IO0: Q3.3 (C)
unnamed: J16.S1 (SHIELD), R74.1
unnamed: Q2.1 (B), R61.1
unnamed: Q3.1 (B), R55.1
unnamed: R56.1, U7.25 (RXD)
unnamed: R59.1, R62.1
unnamed: R59.2, U7.26 (TXD)
RTS: Q2.2 (E), R55.2, U7.24 (~RTS)
RXD0: R62.2
TXD0: R56.2
USB_D+: U7.4 (D+)
USB_D-: U7.5 (D-)
USB_Din+: J16.A6 (D+), J16.B6 (D+)
USB_Din-: J16.A7 (D-), J16.B7 (D-)

Notes on the sheet:
TVS diode in Circuit Protection
USB interface for programming / configuring. I may leave this off the full production run and use a debugger instead.
