tanaes/slide_led_pcb/(commit log)

2025-04-04 draft ready
    [Slide LED connector v0.2.kicad_sch, circuit_protection.kicad_sch, configuration.kicad_sch, ethernet.kicad_sch, i2c.kicad_sch, led.kicad_sch, pixel_bus.kicad_sch, power.kicad_sch]
2025-04-04 changed 24V connector
    [power.kicad_sch]
2025-04-04 changed switches
    [config.kicad_sch, power.kicad_sch]
2025-04-04 updated LED resistor values
    [circuit_protection.kicad_sch, config.kicad_sch, ethernet.kicad_sch, i2c.kicad_sch, led.kicad_sch]
2025-04-04 schematic annotation
    [config.kicad_sch, power.kicad_sch]
2025-04-04 Changed 24V eFuse to TPS26632 and added reverse polarity protection
    [circuit_protection.kicad_sch]
2025-04-04 added 5V input ideal diode reverse polarity protection
    [circuit_protection.kicad_sch]
2025-04-04 made compatible with different 24V eFuse SKUs
    [circuit_protection.kicad_sch]
2025-04-05 MOAR STITCHING and some cleanup
    [Slide LED connector v0.2.kicad_sch, circuit_protection.kicad_sch, power.kicad_sch]
2025-04-06 added power diagram
    [Slide LED connector v0.2.kicad_sch, circuit_protection.kicad_sch]
